vrestihnat/reprap-i3-compatible/docs/Frame_i3_2.png

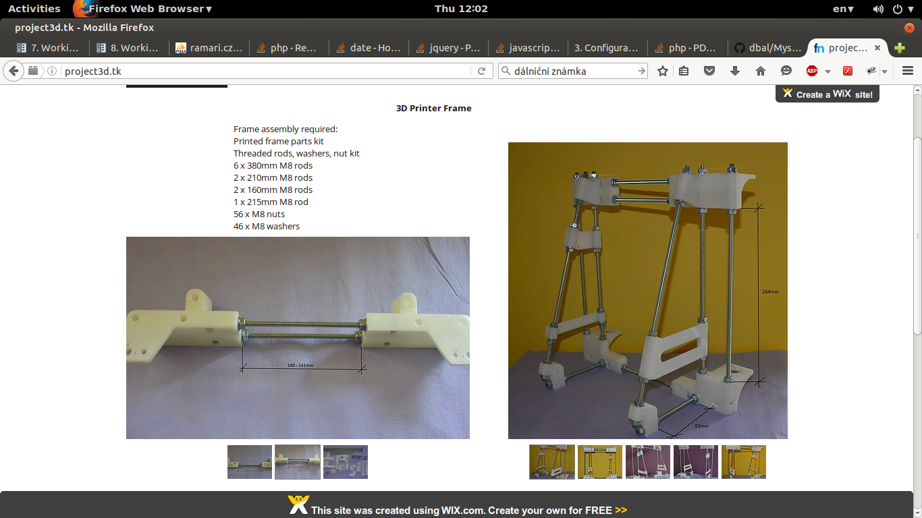
docs/Frame_i3_2.png
