vrestihnat/reprap-i3-compatible/docs/neschopenka.jpg

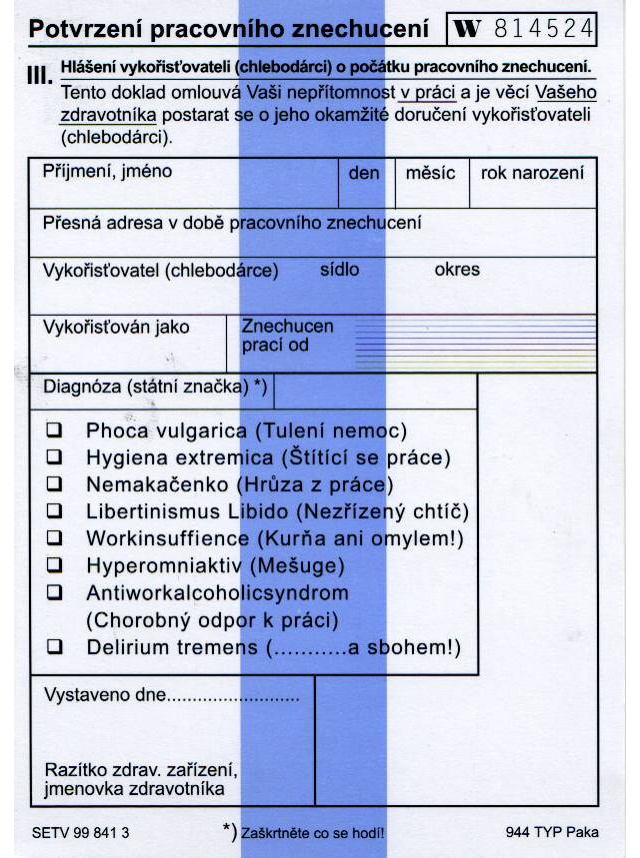
docs/neschopenka.jpg
