vrestihnat/reprap-i3-compatible/README.md

# reprap-i3-compatible
3D printer Prusa i3 compatible. Models based on openscad.
