vrestihnat/reprap-i3-compatible/docs/ramps8.png

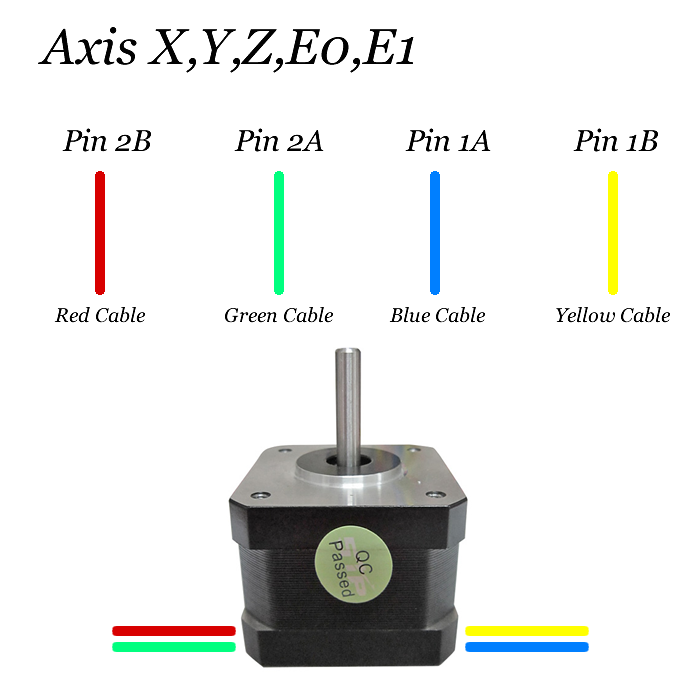
docs/ramps8.png
