vrestihnat/reprap-i3-compatible/output/stl/idlerxend_xrodclamps.stl

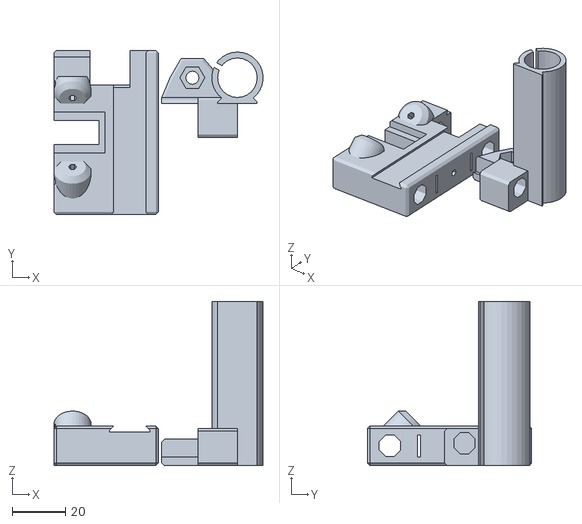
[picture p4: CAD file, 2016-04-21]
output/stl/idlerxend_xrodclamps.stl
78.8 x 62.0 x 62.0
