vrestihnat/reprap-i3-compatible/output/stl/prusa_Y-Carriage_v2_middle_final_fixed.stl

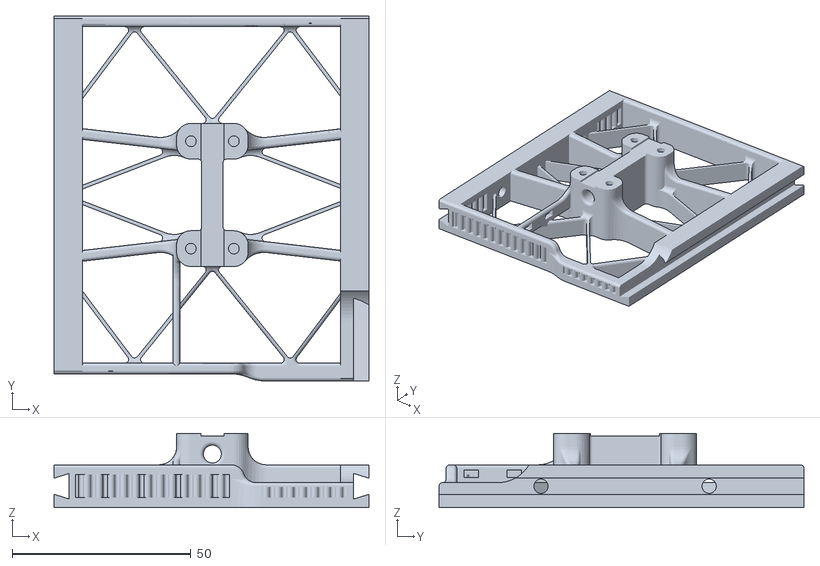
[picture p5: CAD file, 2016-04-21]
output/stl/prusa_Y-Carriage_v2_middle_final_fixed.stl
88.0 x 102.0 x 20.8
