vrestihnat/reprap-i3-compatible/output/stl/P3Steel_i3_Rework_X-carriage_1a.stl

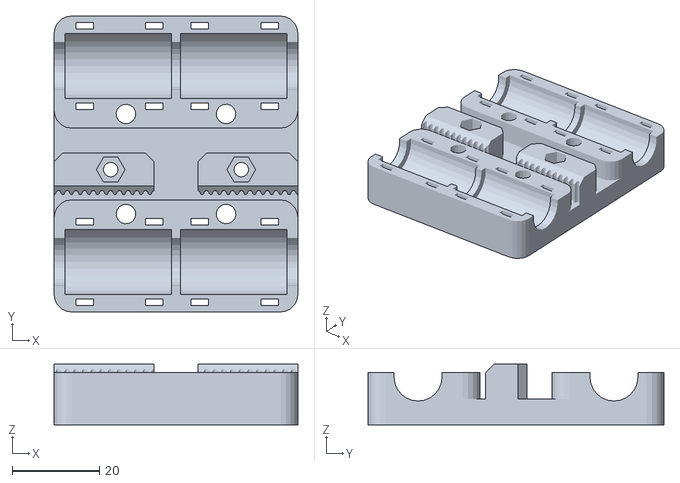
[picture p6: CAD file, 2016-04-21]
output/stl/P3Steel_i3_Rework_X-carriage_1a.stl
56.0 x 68.0 x 14.0
