vrestihnat/reprap-i3-compatible/output/stl/Prusa_i3_reinforced_Y_motor_mount286ba1bcd24332abc7d6fc369e44275b-y-motor.stl

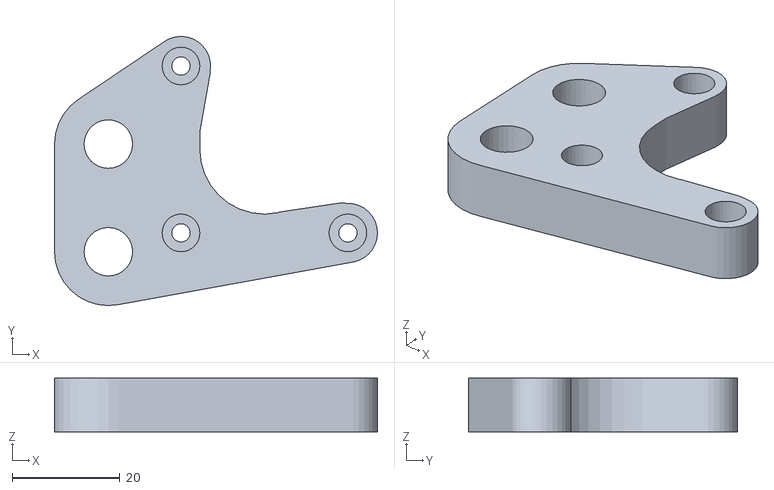
[picture p7: CAD file, 2016-04-21]
output/stl/Prusa_i3_reinforced_Y_motor_mount286ba1bcd24332abc7d6fc369e44275b-y-motor.stl
60.0 x 50.0 x 10.0
