vrestihnat/reprap-i3-compatible/output/stl/idler608.stl

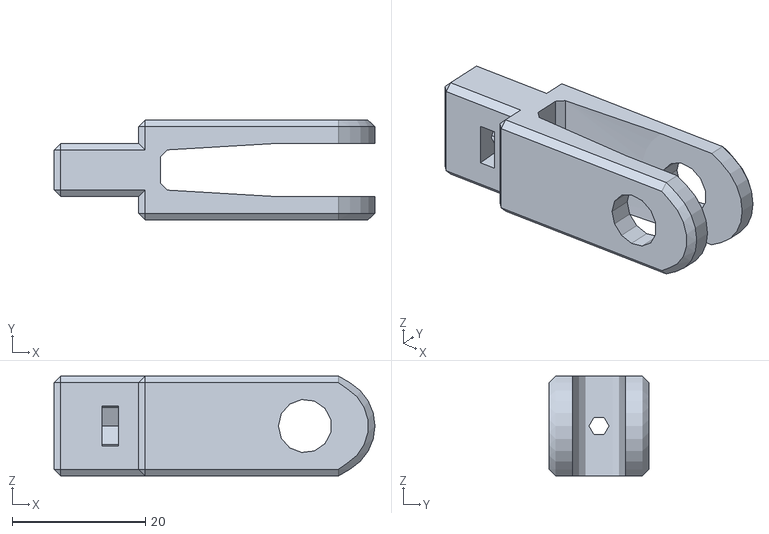
[picture p8: CAD file, 2016-04-21]
output/stl/idler608.stl
48.1 x 15.0 x 15.0
