vrestihnat/reprap-i3-compatible/output/stl/top-ends-frame-prusa-i3-compatible_right.stl

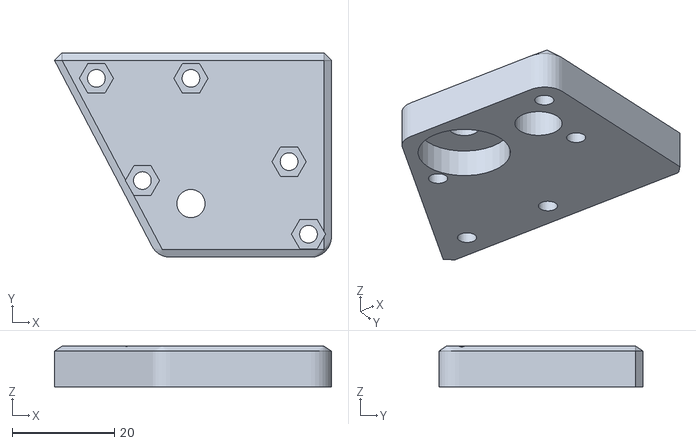
[picture p9: CAD file, 2016-04-21]
output/stl/top-ends-frame-prusa-i3-compatible_right.stl
54.2 x 40.0 x 8.00
