vrestihnat/reprap-i3-compatible/output/stl/Power_Suplly_Holder_-_1.STL

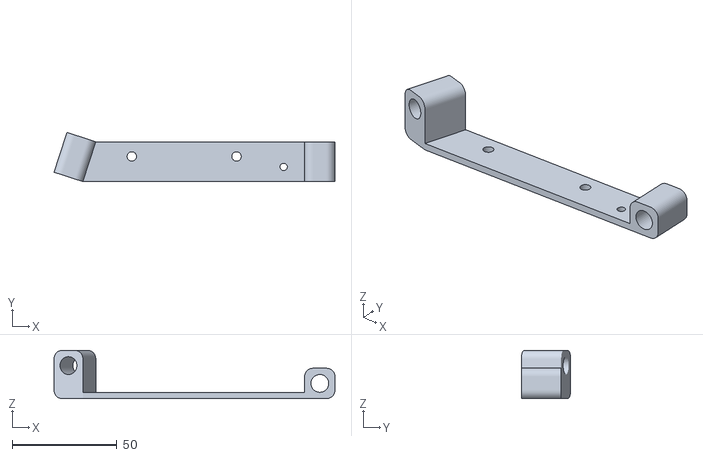
[picture p10: CAD file, 2016-04-21]
output/stl/Power_Suplly_Holder_-_1.STL
134.1 x 23.5 x 23.0
