vrestihnat/reprap-i3-compatible/output/stl/stop_warp_Variklio_Tvirtinimas.stl

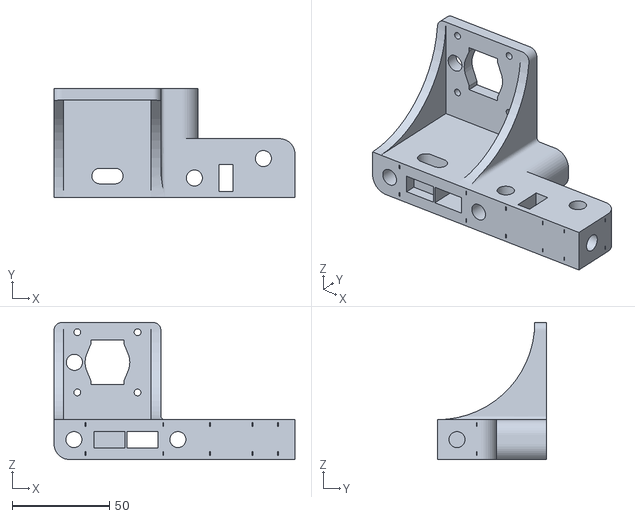
[picture p11: CAD file, 2016-04-21]
output/stl/stop_warp_Variklio_Tvirtinimas.stl
124.0 x 56.0 x 70.5
