vrestihnat/reprap-i3-compatible/output/stl/prusa_Y-Carriage_v2_left_final_fixed.stl

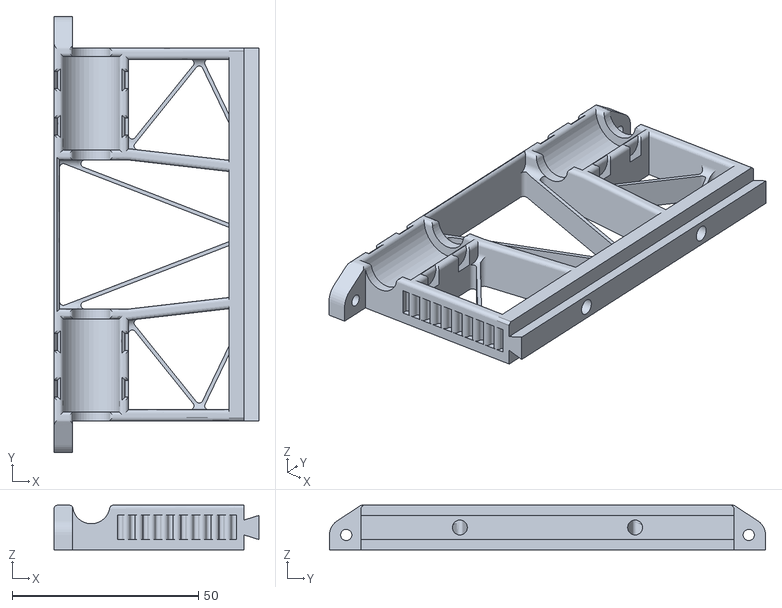
[picture p12: CAD file, 2016-04-21]
output/stl/prusa_Y-Carriage_v2_left_final_fixed.stl
55.0 x 117.0 x 12.0
