vrestihnat/reprap-i3-compatible/output/stl/optical_end_switch_y_i3_fixed.stl

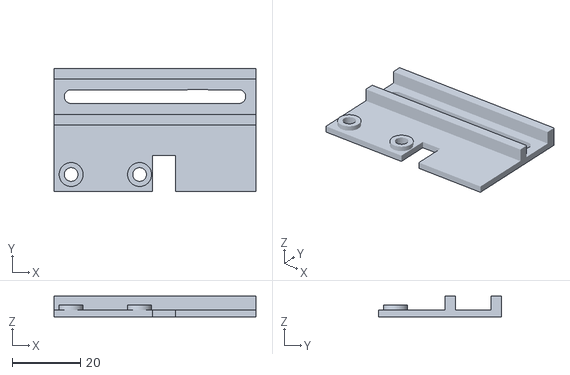
[picture p13: CAD file, 2016-04-21]
output/stl/optical_end_switch_y_i3_fixed.stl
59.0 x 36.0 x 6.00
