vrestihnat/reprap-i3-compatible/output/stl/dual_bearing_y_idler.stl

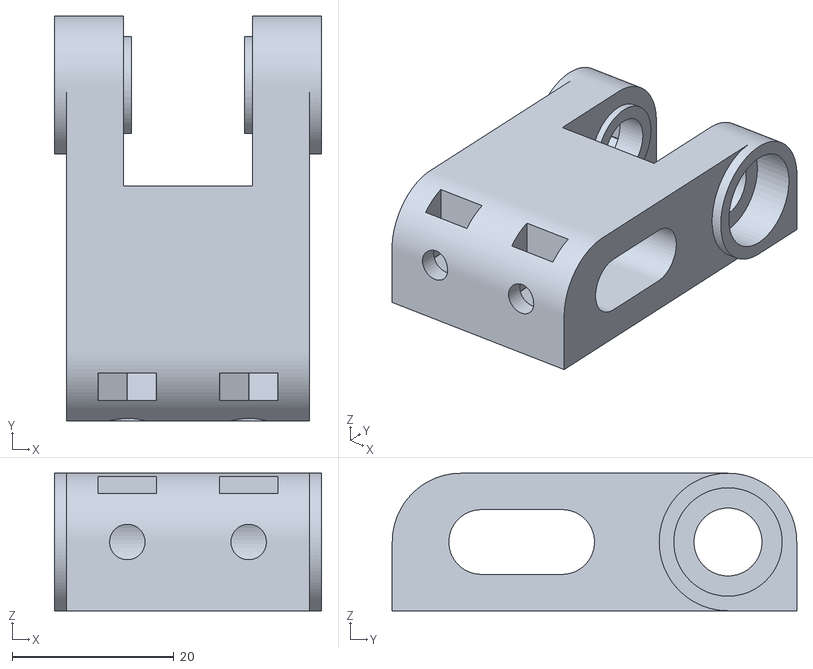
[picture p14: CAD file, 2016-04-21]
output/stl/dual_bearing_y_idler.stl
33.0 x 50.0 x 17.0
