vrestihnat/reprap-i3-compatible/output/stl/Mega_2560_Holder.STL

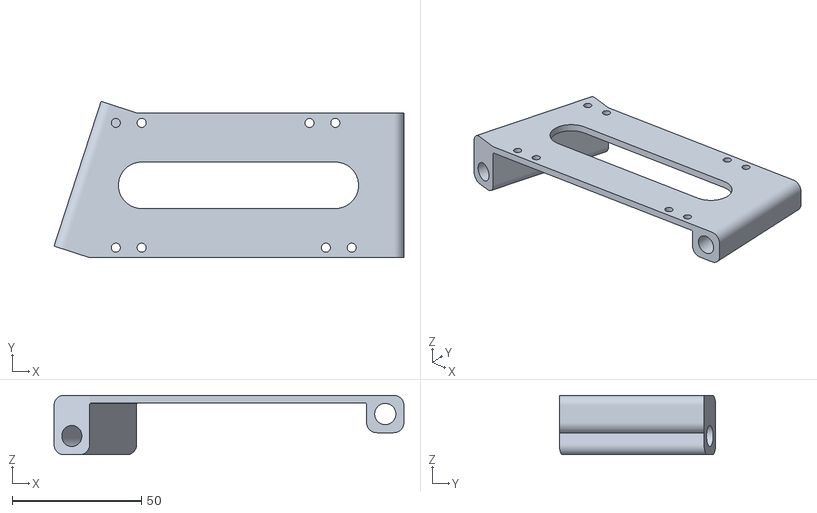
[picture p15: CAD file, 2016-04-21]
output/stl/Mega_2560_Holder.STL
135.4 x 60.5 x 23.0
