vrestihnat/reprap-i3-compatible/output/stl/Apacia_Tvirtinimas_Print_two.STL

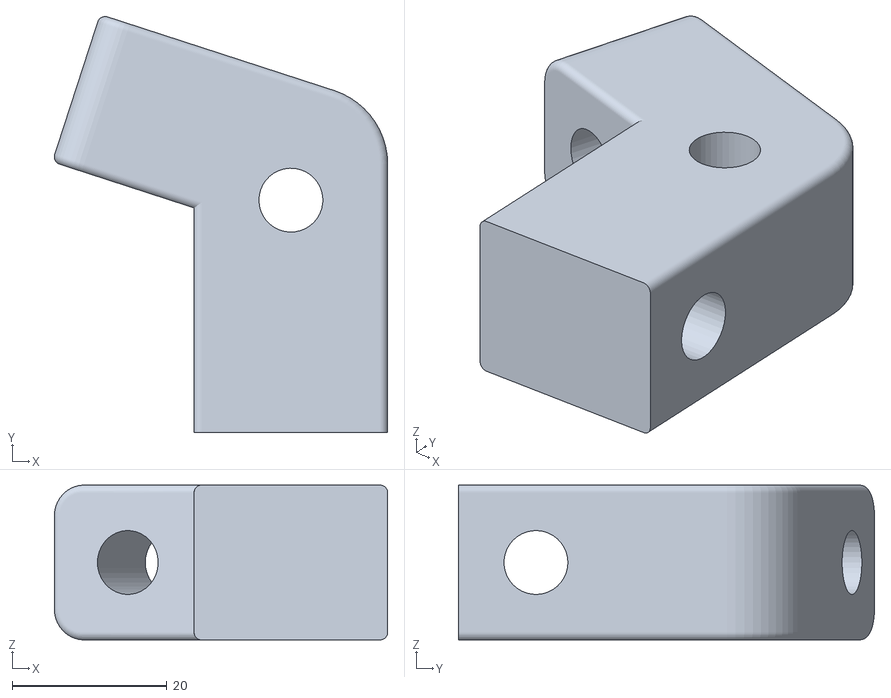
[picture p16: CAD file, 2016-04-21]
output/stl/Apacia_Tvirtinimas_Print_two.STL
43.0 x 53.7 x 20.0
