vrestihnat/reprap-i3-compatible/output/stl/Virsus_Pagalbine_Print_two.STL

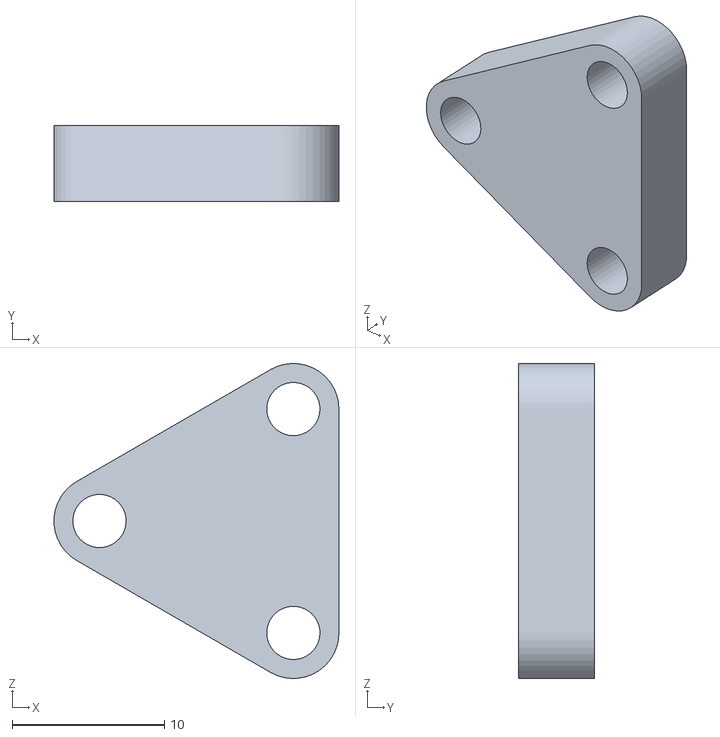
[picture p17: CAD file, 2016-04-21]
output/stl/Virsus_Pagalbine_Print_two.STL
18.7 x 5.00 x 20.7
