vrestihnat/reprap-i3-compatible/output/stl/Power_Suplly_Holder_-_2.STL

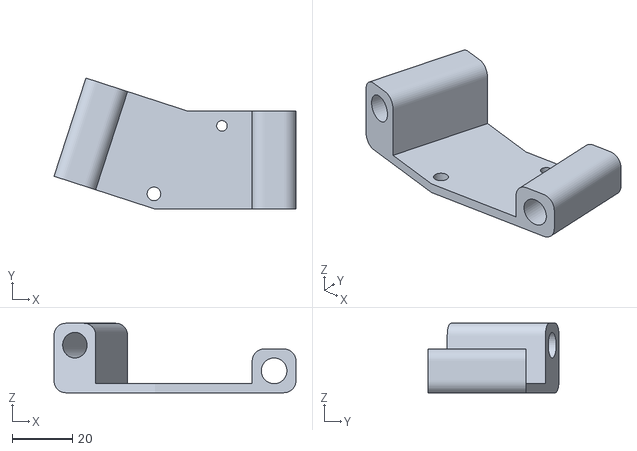
[picture p18: CAD file, 2016-04-21]
output/stl/Power_Suplly_Holder_-_2.STL
80.1 x 43.3 x 23.0
