vrestihnat/reprap-i3-compatible/output/stl/prusa_Y-Carriage_v2.1__optostop2_fixed.stl

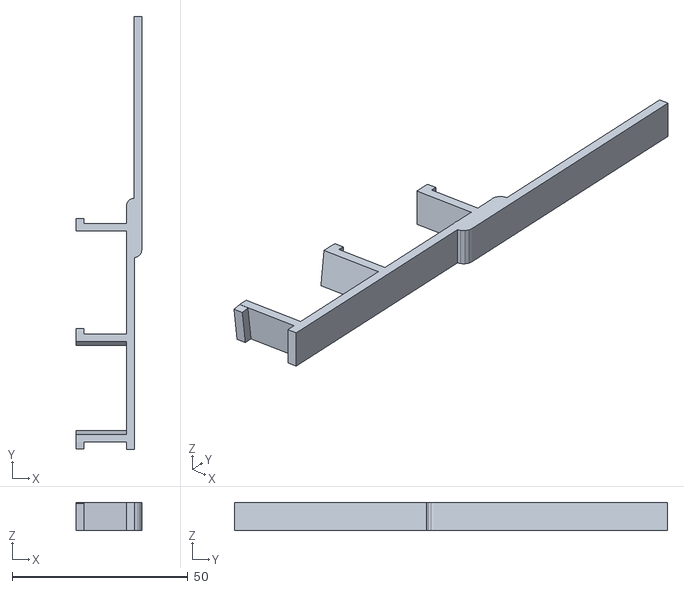
[picture p19: CAD file, 2016-04-21]
output/stl/prusa_Y-Carriage_v2.1__optostop2_fixed.stl
18.7 x 123.2 x 8.00
