vrestihnat/reprap-i3-compatible/output/stl/my_z-axis-backlash-idler.stl

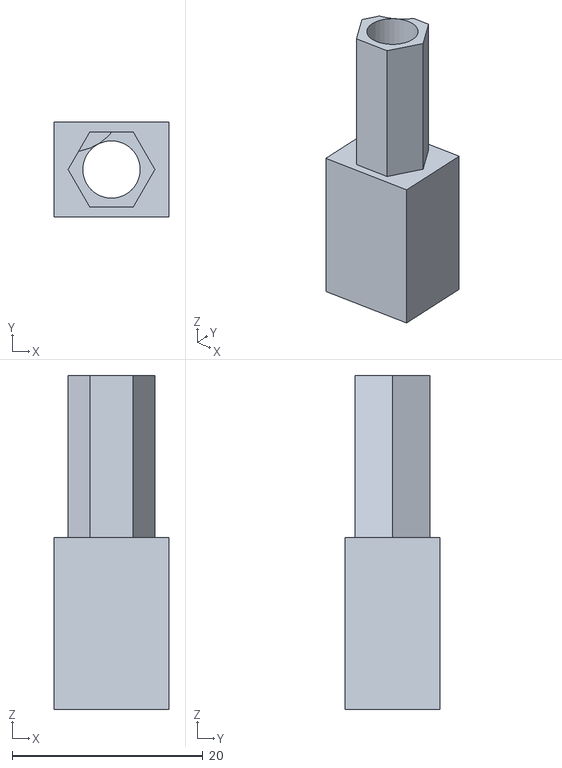
[picture p20: CAD file, 2016-04-21]
output/stl/my_z-axis-backlash-idler.stl
12.0 x 10.0 x 35.0
