vrestihnat/reprap-i3-compatible/output/stl/stop_warp_Virsus_Tvirtinimas_1.stl

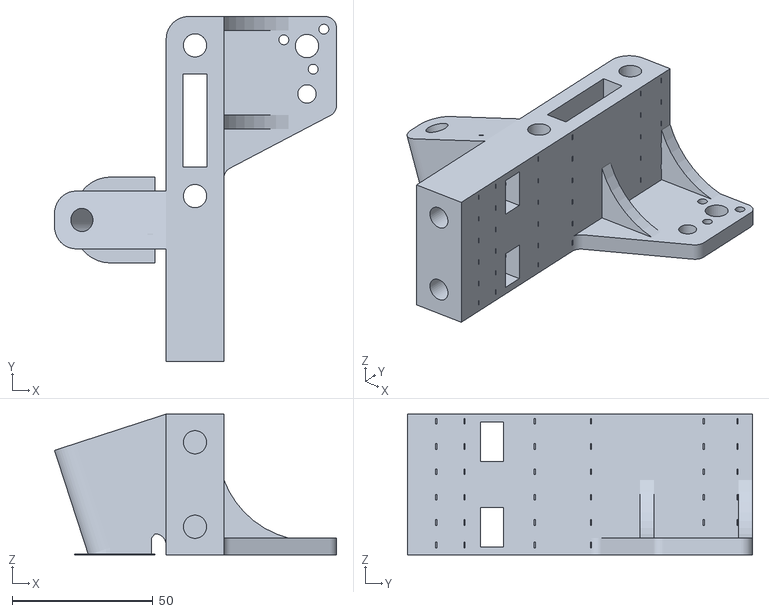
[picture p21: CAD file, 2016-04-21]
output/stl/stop_warp_Virsus_Tvirtinimas_1.stl
100.2 x 122.5 x 50.0
