vrestihnat/reprap-i3-compatible/output/stl/motorxend_zendstop.stl

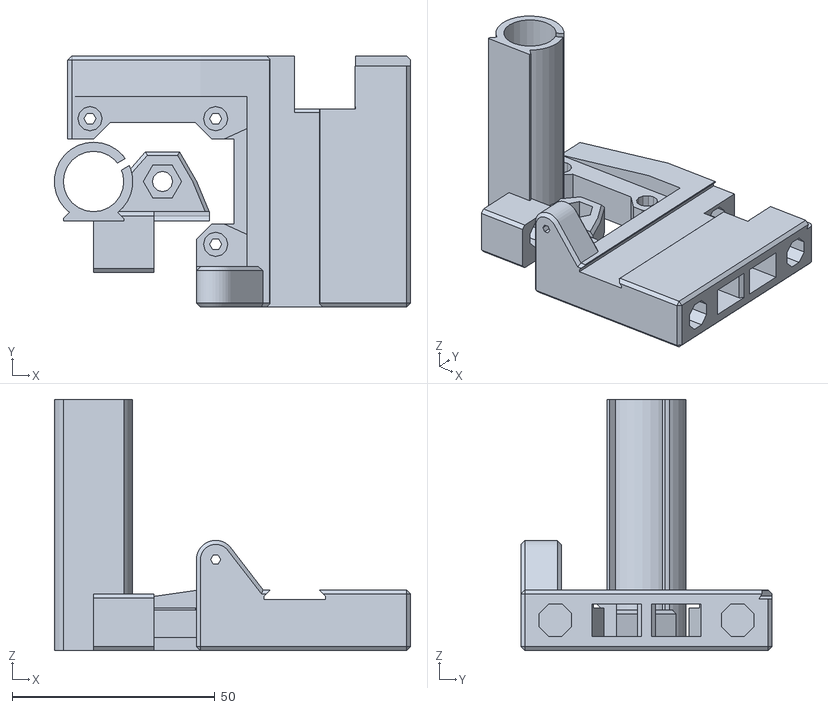
[picture p22: CAD file, 2016-04-21]
output/stl/motorxend_zendstop.stl
87.8 x 62.0 x 62.0
