vrestihnat/reprap-i3-compatible/(list of files, cad)

Other CAD files:
output/stl/stop_warp_Variklio_Tvirtinimas_2.stl
output/stl/top-ends-frame-prusa-i3-compatible_left.stl
output/stl/prusa_Y-Carriage_v2_right_final_fixed.stl
output/stl/my_z-axis-backlash-motor.stl
output/stl/stop_warp_Virsus_Tvirtinimas_2.stl
src/openscad/my_z-axis-backlash-m5.scad
src/openscad/top-ends-frame-prusa-i3-compatible.scad
